mjankovec/MiSKo3/README.md

# MiSKo3
Student microcontroller development board based on STM32G474QET
