mjankovec/MiSKo3/Hardware/Panel production/Bill of Materials-MISKO3.xlsx

Line # | Designator | Code | Value | Description | Name | Quantity | Layer | Assembly | Provider | Manufacturer 1 | Manufacturer Part Number 1 | Supplier 1 | Supplier Part Number 1 | Supplier Unit Price 1
10 | A1 | Q-PBUTTON | Reset | Tactile switch SMD | Button_6x6 | 1 |  | Manual | FE | Wurth Electronics | 430182043816 | Würth elektronik | 430182043816 | 0.071
11 | BTN_DOWN1, BTN_ESC1, BTN_LEFT1, BTN_OK1, BTN_RIGHT1, BTN_UP1 | Q-PBUTTON | UI | Tactile switch SMD | Button_6x6 | 6 |  | Manual | FE | Wurth Electronics | 430182043816 | Würth elektronik | 430182043816 | 0.071
12 | C1, C2, C4, C5, C6, C7, C29, C30, C36 | NB7-4U7-25V | 4u7 | Capacitor |  | 9 |  | P&P | iSYSTEM
13 | C3 | NH4-1N2KV | 1n/2kV | Capacitor |  | 1 |  | P&P | iSYSTEM
14 | C8, C11, C17, C18, C19, C20, C21, C23, C27, C28, C35, C38, C39, C40, C42, C46, C50, C51, C52, C53, C54, C55, C56, C57, C58, C59, C60 | NB6-100N | 100n | Capacitor |  | 27 |  | P&P | iSYSTEM
15 | C9, C10, C14, C15, C16 | NB7-1U-25V | 1u | Capacitor |  | 5 |  | P&P | iSYSTEM
16 | C12, C13, C22, C24, C25 | NB2-10P | 10p | Capacitor |  | 5 |  | P&P | iSYSTEM
18 | C31, C32, C33, C34, C41, C43, C44, C45, C47, C48, C49 | NB2-10P, NB6-100N | NP | Capacitor |  | 11 |  | None
17 | C37 | NB4-1N | 1n | Capacitor |  | 1 |  | P&P | iSYSTEM
19 | D1 | KDSP3051 |  | TVS DIODE 6V 17V SOT23-6 | SP3051-04HTG | 1 |  | P&P | iSYSTEM
20 | D2, D3, D4, D5 | KDBAT54H |  | Schottky Barrier Diode, 2-Pin SOD-323, Pb-Free, Tape and Reel | BAT54HT1G | 4 |  | P&P | iSYSTEM
21 | D6 | KD-PESD1LIN |  | LIN-bus ESD protection diode | PESD1LIN | 1 |  | P&P | iSYSTEM
 | D7 | KD-NUP2125 |  | SOT23127P600-8N Dual Line Automotive Bus protection Datasheet: https://www.onsemi.com/pdf/datasheet/nup2125-d.pdf | NUP2125 | 1 |  | P&P | iSYSTEM
22 | D8, D9, D10, D11, D12, D13, D14, D15, D16, D17 | KD-ESD7371X |  | TVS Diode (Uni-directional) | ESD7371XV2T1G | 10 |  | P&P | iSYSTEM
23 | FB1, FB2 | LZ-FB0805 |  | Chip Ferrite Bead, 0805, 200Ω @ 100MHz, 0.26Ω, 25%, 500mA | BLM21BB201SN1D | 2 |  | P&P | iSYSTEM
24 | FID1, FID2, FID3 |  |  | according to IPC-7351 - is a 1mm diameter round dot with 2mm solder mask opening | Fiducial | 3 |  | Fiducial
25 | IC1 |  |  | FLASH - NOR Memory IC 128Mb (16M x 8) SPI - Quad I/O, QPI, DTR 133MHz 8-SOIC | W25Q128JVSIM | 1 |  | Optional | FE
26 | J1 | QBUSB-TYPEC-TM |  | USB 3.1 Type C Receptacle WR-COM, Horizontal, SMT / THT | 632723300011 | 1 |  | P&P | FE | Wurth Electronics | 632723300011 | Würth elektronik | 632723300011 | 1.49
27 | J2, J3 |  |  | Header 1x6 (male) | Header 1x6 (male) | 2 |  | None
28 | J4, J6, J8, J9, J10 |  |  | PINHD-1X8 | 8x1F-H8.5 | 5 |  | Manual | FE | Wurth Electronics | 61300811821 | Würth elektronik | 61300811821 | 0.01
29 | J5 |  |  | PINHD-2X18 | 18x2F-H8.5 | 1 |  | Manual | FE | Wurth Electronics | 61303621821 | Würth elektronik | 61303621821 | 0.01
30 | J7 |  |  | PINHD-1X10 | 10x1F-H8.5 | 1 |  | Manual | FE | Wurth Electronics | 61301011821 | Würth elektronik | 61301011821 | 0.01
31 | J11 |  |  | TE connectivity FPC 5 pin 0.5 mm ZIF top contact female connector 1734839-5 | FPC 5 pin | 1 |  | P&P | FE | TE Connectivity | 1734839-5 | Farnell | 3398656 | 0.268
32 | J12 | QYS50-20-M-SMD-LC |  | Trace/JTAG/SW connector | ESHF-110-01-L-D-SM-LC | 1 |  | Optional | iSYSTEM
33 | LED1, LED3, LED4 | KLC-G |  | Green light-emitting diode | GREEN | 3 |  | P&P | iSYSTEM
34 | LED2, LED5 | KLC-R |  | Red light-emitting diode | RED | 2 |  | P&P | iSYSTEM
35 | LED6, LED7, LED8, LED9, LED10, LED11, LED12, LED13 | KLB-B |  | LED | BLUE | 8 |  | Manual | iSYSTEM
36 | M1, M2 | BSH103-T/R |  | BSH103-T/R (NMOS) | BSS138 | 2 |  | P&P | iSYSTEM
37 | Q1 | KT-NPN-S |  | Bipolar (BJT) Transistor NPN 45V 100mA 100MHz 250mW Surface Mount TO-236AB | BC847C | 1 |  | P&P | iSYSTEM
38 | R1, R2, R3, R4, R14, R15, R16, R18, R21, R26, R27, R29, R32, R41, R43, R44, R52, R57, R58, R59, R62, R63, R94, R95 | LC5-10K | 10k | R |  | 24 |  | P&P | iSYSTEM
39 | R5 | LC7-1M | 1M | R |  | 1 |  | P&P | iSYSTEM
40 | R6, R7, R8, R9, R10, R11, R20, R22, R23, R24, R36, R37, R38, R47, R49, R50, R51, R60, R67, R68, R69, R70, R71, R72, R73, R74, R75, R76, R77, R78, R79, R80, R81, R82, R83, R84, R85, R86, R87, R88, R90, R91, R92, R93 | LC4-1K | 1k | R |  | 44 |  | P&P | iSYSTEM
41 | R12, R13, R25, R28, R30, R31, R33, R34, R39, R40, R42, R53, R54, R55, R56, R64, R65, R89 | LC2-56E | 56 | R |  | 18 |  | P&P | iSYSTEM
42 | R17, R19, R35, R45, R46, R48 | LC6-100K | 100k | R |  | 6 |  | P&P | iSYSTEM
43 | R61, R66 |  | NP | R |  | 2 |  | None
44 | SB1, SB2, SB3, SB4, SB5, SB6, SB7 |  |  |  | SD_JUMP | 7 |  | None
45 | T1, T2, T3, T4, T5, T6, T7, T8, T9, T10, T11, T12, T13 |  |  |  |  | 13 |  | None
 | U1 | FRL-33-LM1117 |  | 800mA Low-Dropout Linear Regulator, 4-pin SOT-223, Pb-Free DataSheet: https://www.ti.com/lit/ds/symlink/lm1117.pdf?ts=1629838143263 | LM1117MPX-3.3 | 1 |  | P&P | iSYSTEM | Texas Instruments | TEXASINSTRUMENTS
 | U2 | FS-MIC2544 |  | IC PWR SWITCH N-CHAN 1:1 8MSOP DataSheet: https://ww1.microchip.com/downloads/en/DeviceDoc/20005725B.pdf | MIC2548-1YM | 1 |  | P&P | iSYSTEM
 | U3 | FC-USB2422MJ |  | IC HUB CTLR USB 2.0 24QFN DataSheet: http://ww1.microchip.com/downloads/en/devicedoc/00001726b.pdf | USB2422/MJ | 1 |  | P&P | iSYSTEM
 | U4 | BSTM32F103CBT6 |  | ARM Cortex-M3 32-bit MCU, 128 KB Flash, 20 KB Internal RAM, 37 I/Os, 48-pin LQFP, -40 to 85 degC, Tray DataSheet: https://www.st.com/resource/en/datasheet/stm32f103c8.pdf About STLINK: https://www.st.com/resource/en/user_manual/dm00231744-stm32-nucleo-32-boards-mb1180-stmicroelectronics.pdf | STM32F103CBT6 | 1 |  | P&P | FE
6 | U5 | KLCD-XPT2046 |  | LCD touch controller | XPT2046 | 1 |  | P&P | FE | Shenzhen XPTEK Tech | XPT2046 | LCSC | C19076 | 0.303
47 | U6 |  |  |  | LCD_TFT_2.8inch | 1 |  | Manual | FE | WS Winstar | WF28ETLAJDNT0 | IC elektronika | WF28ETLAJDNT0 | 17.06
 | U7 | FC-TJA1027 |  | Integrated Circuit, LIN Transciever DataSheet: https://www.nxp.com/docs/en/data-sheet/TJA1027.pdf | MCP2004 | 1 |  | P&P | iSYSTEM
48 | U8 | FC-MCP2562FD |  | IC TRANSCEIVER 1/1 8SOIC | MCP2562FDT-E/SN | 1 |  | P&P | iSYSTEM
 | U9 | BSTM32G474QET6 |  | Mainstream Arm Cortex - M3 MCU 170Mhz with 512 Kbytes of Flash memory, Math Accelerator, HR timer, High Analog level integration DataSheet: https://www.st.com/en/microcontrollers-microprocessors/stm32g474qe.html | STM32G474QET6 | 1 |  | P&P | iSYSTEM
 | Y1 |  |  |  | CFPX-104 24MHz | 1 |  | P&P | FE |  |  | Würth elektronik | 830032817
 | Y2 |  |  |  | CFPX-104 8MHZ | 1 |  | P&P | FE |  |  | Würth elektronik | 830055901
