mjankovec/MiSKo3/Hardware/Documentation/Misko3 pin mapping.xlsx

Sheet: MCU pinout
Position | Name | Type | Signal | Label | AF0 | AF1 | AF2 | AF3 | AF4 | AF5 | AF6 | AF7 | AF8 | AF9 | AF10 | AF11 | AF12 | AF13 | AF14 | AF15
1 | PE2 | I/O | SYS_TRACECLK |  | SYS_TRACECLK |  | TIM3_CH1 | SAI1_CK1 |  | SPI4_SCK | TIM20_CH1 |  |  |  |  |  | FMC_A23 | SAI1_MCLK_A |  | EVENTOUT
2 | PE3 | I/O | SYS_TRACED0 |  | SYS_TRACED0 |  | TIM3_CH2 |  |  | SPI4_NSS | TIM20_CH2 |  |  |  |  |  | FMC_A19 | SAI1_SD_B |  | EVENTOUT
3 | PE4 | I/O | SYS_TRACED1 |  | SYS_TRACED1 |  | TIM3_CH3 | SAI1_D2 |  | SPI4_NSS | TIM20_CH1N |  |  |  |  |  | FMC_A20 | SAI1_FS_A |  | EVENTOUT
4 | PE5 | I/O | SYS_TRACED2 |  | SYS_TRACED2 |  | TIM3_CH4 | SAI1_CK2 |  | SPI4_MISO | TIM20_CH2N |  |  |  |  |  | FMC_A21 | SAI1_SCK_A |  | EVENTOUT
5 | PE6 | I/O | SYS_TRACED3 |  | SYS_TRACED3 |  |  | SAI1_D1 |  | SPI4_MOSI | TIM20_CH3N |  |  |  |  |  | FMC_A22 | SAI1_SD_A |  | EVENTOUT
6 | VBAT | Power
7 | PC13 | Input | GPIO_Input | JOY_BTN |  |  | TIM1_BKIN |  | TIM1_CH1N |  | TIM8_CH4N |  |  |  |  |  |  |  |  | EVENTOUT
8 | PC14-OSC32_IN | I/O | GPIO_EXTI14 | BTN_ESC |  |  |  |  |  |  |  |  |  |  |  |  |  |  |  | EVENTOUT
9 | PC15-OSC32_OUT | Input | GPIO_Input | BTN_OK |  |  |  |  |  |  |  |  |  |  |  |  |  |  |  | EVENTOUT
10 | PF3 | Output | GPIO_Output | LED1 |  |  | TIM20_CH4 |  | I2C3_SCL |  |  |  |  |  |  |  | FMC_A3 |  |  | EVENTOUT
11 | PF4 | Output | GPIO_Output | LED2 |  |  | COMP1_OUT | TIM20_CH1N | I2C3_SDA |  |  |  |  |  |  |  | FMC_A4 |  |  | EVENTOUT
12 | VSS | Power
13 | VDD | Power
14 | PF5 | Output | GPIO_Output | LED3 |  |  | TIM20_CH2N |  |  |  |  |  |  |  |  |  | FMC_A5 |  |  | EVENTOUT
15 | PF7 | I/O | TIM5_CH2 | PWM2 |  |  | TIM20_BKIN |  |  |  | TIM5_CH2 |  |  |  | QUADSPI1_BK1_IO2 |  | FMC_A1 | SAI1_MCLK_B |  | EVENTOUT
16 | PF8 | I/O | TIM5_CH3 | PWM3 |  |  | TIM20_BKIN2 |  |  |  | TIM5_CH3 |  |  |  | QUADSPI1_BK1_IO0 |  | FMC_A24 | SAI1_SCK_B |  | EVENTOUT
17 | PF9 | I/O | TIM5_CH4 | PWM4 |  |  | TIM20_BKIN | TIM15_CH1 |  | SPI2_SCK | TIM5_CH4 |  |  |  | QUADSPI1_BK1_IO1 |  | FMC_A25 | SAI1_FS_B |  | EVENTOUT
18 | PF10 | I/O | TIM15_CH2 | PWM5 |  |  | TIM20_BKIN2 | TIM15_CH2 |  | SPI2_SCK |  |  |  |  | QUADSPI1_CLK |  | FMC_A0 | SAI1_D3 |  | EVENTOUT
19 | PF0-OSC_IN | I/O | RCC_OSC_IN | MCI |  |  |  |  | I2C2_SDA | I2S2_WS/SPI2_NSS | TIM1_CH3N |  |  |  |  |  |  |  |  | EVENTOUT
20 | PF1-OSC_OUT | I/O | ADC2_IN10 | AD5 |  |  |  |  |  | I2S2_CK/SPI2_SCK |  |  |  |  |  |  |  |  |  | EVENTOUT
21 | PG10-NRST | I/O |  |  | RCC_MCO |  |  |  |  |  |  |  |  |  |  |  |  |  |  | EVENTOUT
22 | PC0 | Output | GPIO_Output | LED4 |  | LPTIM1_IN1 | TIM1_CH1 |  |  |  |  |  | LPUART1_RX |  |  |  |  |  |  | EVENTOUT
23 | PC1 | Output | GPIO_Output | LED5 |  | LPTIM1_OUT | TIM1_CH2 |  |  |  |  |  | LPUART1_TX |  | QUADSPI1_BK2_IO0 |  |  | SAI1_SD_A |  | EVENTOUT
24 | PC2 | Output | GPIO_Output | LED6 |  | LPTIM1_IN2 | TIM1_CH3 | COMP3_OUT |  |  | TIM20_CH2 |  |  |  | QUADSPI1_BK2_IO1 |  |  |  |  | EVENTOUT
25 | PC3 | Output | GPIO_Output | LED7 |  | LPTIM1_ETR | TIM1_CH4 | SAI1_D1 |  |  | TIM1_BKIN2 |  |  |  | QUADSPI1_BK2_IO2 |  |  | SAI1_SD_A |  | EVENTOUT
26 | PF2 | Output | GPIO_Output | LED0 |  |  | TIM20_CH3 |  | I2C2_SMBA |  |  |  |  |  |  |  | FMC_A2 |  |  | EVENTOUT
27 | PA0 | I/O | ADC1_IN1 | AD0 |  | TIM2_CH1 | TIM5_CH1 |  |  |  |  | USART2_CTS/USART2_NSS | COMP1_OUT | TIM8_BKIN | TIM8_ETR |  |  |  | TIM2_ETR | EVENTOUT
28 | PA1 | I/O | ADC1_IN2 | AD1 | RTC_REFIN | TIM2_CH2 | TIM5_CH2 |  |  |  |  | USART2_DE/USART2_RTS |  | TIM15_CH1N |  |  |  |  |  | EVENTOUT
29 | PA2 | I/O | ADC1_IN3 | AD2 |  | TIM2_CH3 | TIM5_CH3 |  |  |  |  | USART2_TX | COMP2_OUT | TIM15_CH1 | QUADSPI1_BK1_NCS |  | LPUART1_TX |  | UCPD1_FRSTX1/UCPD1_FRSTX2 | EVENTOUT
30 | VSS | Power
31 | VDD | Power
32 | PA3 | I/O | ADC1_IN4 | AD3 |  | TIM2_CH4 | TIM5_CH4 | SAI1_CK1 |  |  |  | USART2_RX |  | TIM15_CH2 | QUADSPI1_CLK |  | LPUART1_RX | SAI1_MCLK_A |  | EVENTOUT
33 | PA4 | I/O | DAC1_OUT1 | DAC0 |  |  | TIM3_CH2 |  |  | SPI1_NSS | I2S3_WS/SPI3_NSS | USART2_CK |  |  |  |  |  | SAI1_FS_B |  | EVENTOUT
34 | PA5 | I/O | ADC2_IN13 | AD8 |  | TIM2_CH1 | TIM2_ETR |  |  | SPI1_SCK |  |  |  |  |  |  |  |  | UCPD1_FRSTX1/UCPD1_FRSTX2 | EVENTOUT
35 | PA6 | I/O | DAC2_OUT1 | DAC0 |  | TIM16_CH1 | TIM3_CH1 |  | TIM8_BKIN | SPI1_MISO | TIM1_BKIN |  | COMP1_OUT |  | QUADSPI1_BK1_IO3 |  | LPUART1_CTS |  |  | EVENTOUT
36 | PA7 | I/O | QUADSPI1_BK1_IO2 | QSPI_IO2 |  | TIM17_CH1 | TIM3_CH2 |  | TIM8_CH1N | SPI1_MOSI | TIM1_CH1N |  | COMP2_OUT |  | QUADSPI1_BK1_IO2 |  |  |  | UCPD1_FRSTX1/UCPD1_FRSTX2 | EVENTOUT
37 | PC4 | I/O | ADC2_IN5 | AD4 |  |  | TIM1_ETR |  | I2C2_SCL |  |  | USART1_TX |  |  | QUADSPI1_BK2_IO3 |  |  |  |  | EVENTOUT
38 | PC5 | I/O | ADC2_IN11 | AD6 |  |  | TIM15_BKIN | SAI1_D3 |  |  | TIM1_CH4N | USART1_RX |  |  |  |  |  | HRTIM1_EEV10 |  | EVENTOUT
39 | PB0 | I/O | QUADSPI1_BK1_IO1 | QSPI_IO1 |  |  | TIM3_CH3 |  | TIM8_CH2N |  | TIM1_CH2N |  |  |  | QUADSPI1_BK1_IO1 |  |  | HRTIM1_FLT5 | UCPD1_FRSTX1/UCPD1_FRSTX2 | EVENTOUT
40 | PB1 | I/O | QUADSPI1_BK1_IO0 | QSPI_IO0 |  |  | TIM3_CH4 |  | TIM8_CH3N |  | TIM1_CH3N |  | COMP4_OUT |  | QUADSPI1_BK1_IO0 |  | LPUART1_DE/LPUART1_RTS | HRTIM1_SCOUT |  | EVENTOUT
41 | PB2 | I/O | ADC2_IN12 | AD7 | RTC_OUT2 | LPTIM1_OUT | TIM5_CH1 | TIM20_CH1 | I2C3_SMBA |  |  |  |  |  | QUADSPI1_BK2_IO1 |  |  | HRTIM1_SCIN |  | EVENTOUT
42 | VSSA | Power
43 | VREF+ | MonoIO
44 | VREF_+ | MonoIO
45 | VDDA | Power
46 | VSS | Power
47 | VDD | Power
48 | PF11 | I/O | FMC_NE4 | LCD1_CS |  |  | TIM20_ETR |  |  |  |  |  |  |  |  |  | FMC_NE4 |  |  | EVENTOUT
49 | PF12 | I/O | TIM20_CH1 | PWM6 |  |  | TIM20_CH1 |  |  |  |  |  |  |  |  |  | FMC_A6 |  |  | EVENTOUT
50 | PF13 | I/O | TIM20_CH2 | PWM7 |  |  | TIM20_CH2 |  | I2C4_SMBA |  |  |  |  |  |  |  | FMC_A7 |  |  | EVENTOUT
51 | PF14 | I/O | TIM20_CH3 | PWM8 |  |  | TIM20_CH3 |  | I2C4_SCL |  |  |  |  |  |  |  | FMC_A8 |  |  | EVENTOUT
52 | PF15 | I/O | TIM20_CH4 | PWM9 |  |  | TIM20_CH4 |  | I2C4_SDA |  |  |  |  |  |  |  | FMC_A9 |  |  | EVENTOUT
53 | PE7 | I/O | FMC_D4 |  |  |  | TIM1_ETR |  |  |  |  |  |  |  |  |  | FMC_D4/FMC_DA4 | SAI1_SD_B |  | EVENTOUT
54 | PE8 | I/O | FMC_D5 |  |  | TIM5_CH3 | TIM1_CH1N |  |  |  |  |  |  |  |  |  | FMC_D5/FMC_DA5 | SAI1_SCK_B |  | EVENTOUT
55 | PE9 | I/O | FMC_D6 |  |  | TIM5_CH4 | TIM1_CH1 |  |  |  |  |  |  |  |  |  | FMC_D6/FMC_DA6 | SAI1_FS_B |  | EVENTOUT
56 | PE10 | I/O | FMC_D7 |  |  |  | TIM1_CH2N |  |  |  |  |  |  |  | QUADSPI1_CLK |  | FMC_D7/FMC_DA7 | SAI1_MCLK_B |  | EVENTOUT
57 | PE11 | I/O | FMC_D8 |  |  |  | TIM1_CH2 |  |  | SPI4_NSS |  |  |  |  | QUADSPI1_BK1_NCS |  | FMC_D8/FMC_DA8 |  |  | EVENTOUT
58 | PE12 | I/O | FMC_D9 |  |  |  | TIM1_CH3N |  |  | SPI4_SCK |  |  |  |  | QUADSPI1_BK1_IO0 |  | FMC_D9/FMC_DA9 |  |  | EVENTOUT
59 | PE13 | I/O | FMC_D10 |  |  |  | TIM1_CH3 |  |  | SPI4_MISO |  |  |  |  | QUADSPI1_BK1_IO1 |  | FMC_D10/FMC_DA10 |  |  | EVENTOUT
60 | PE14 | I/O | FMC_D11 |  |  |  | TIM1_CH4 |  |  | SPI4_MOSI | TIM1_BKIN2 |  |  |  | QUADSPI1_BK1_IO2 |  | FMC_D11/FMC_DA11 |  |  | EVENTOUT
61 | PE15 | I/O | FMC_D12 |  |  |  | TIM1_BKIN |  |  |  | TIM1_CH4N | USART3_RX |  |  | QUADSPI1_BK1_IO3 |  | FMC_D12/FMC_DA12 |  |  | EVENTOUT
62 | PB10 | I/O | QUADSPI1_CLK | QSPI_CLK |  | TIM2_CH3 |  |  |  |  |  | USART3_TX | LPUART1_RX |  | QUADSPI1_CLK |  | TIM1_BKIN | HRTIM1_FLT3 | SAI1_SCK_A | EVENTOUT
63 | VSS | Power
64 | VDD | Power
65 | PB11 | I/O | QUADSPI1_BK1_NCS | QSPI_NCS |  | TIM2_CH4 |  |  |  |  |  | USART3_RX | LPUART1_TX |  | QUADSPI1_BK1_NCS |  |  | HRTIM1_FLT4 |  | EVENTOUT
66 | PB12 | I/O | FDCAN2_RX | CAN2_RX |  |  | TIM5_ETR |  | I2C2_SMBA | I2S2_WS/SPI2_NSS | TIM1_BKIN | USART3_CK | LPUART1_DE/LPUART1_RTS | FDCAN2_RX |  |  |  | HRTIM1_CHC1 |  | EVENTOUT
67 | PB13 | I/O | FDCAN2_TX | CAN2_TX |  |  |  |  |  | I2S2_CK/SPI2_SCK | TIM1_CH1N | USART3_CTS/USART3_NSS | LPUART1_CTS | FDCAN2_TX |  |  |  | HRTIM1_CHC2 |  | EVENTOUT
68 | PB14 | I/O | ADC4_IN4 | JOY_X |  | TIM15_CH1 |  |  |  | SPI2_MISO | TIM1_CH2N | USART3_DE/USART3_RTS | COMP4_OUT |  |  |  |  | HRTIM1_CHD1 |  | EVENTOUT
69 | PB15 | I/O | ADC4_IN5 | JOY_Y | RTC_REFIN | TIM15_CH2 | TIM15_CH1N | COMP3_OUT | TIM1_CH3N | I2S2_SD/SPI2_MOSI |  |  |  |  |  |  |  | HRTIM1_CHD2 |  | EVENTOUT
70 | PD8 | I/O | FMC_D13 |  |  |  |  |  |  |  |  | USART3_TX |  |  |  |  | FMC_D13/FMC_DA13 |  |  | EVENTOUT
71 | PD9 | I/O | FMC_D14 |  |  |  |  |  |  |  |  | USART3_RX |  |  |  |  | FMC_D14/FMC_DA14 |  |  | EVENTOUT
72 | PD10 | I/O | FMC_D15 |  |  |  |  |  |  |  |  | USART3_CK |  |  |  |  | FMC_D15/FMC_DA15 |  |  | EVENTOUT
73 | PD11 | I/O | ADC3_IN8 | AD9 |  | TIM5_ETR |  |  | I2C4_SMBA |  |  | USART3_CTS/USART3_NSS |  |  |  |  | FMC_A16 |  |  | EVENTOUT
74 | PD12 | I/O | ADC3_IN9 | AD10 |  |  | TIM4_CH1 |  |  |  |  | USART3_DE/USART3_RTS |  |  |  |  | FMC_A17 |  |  | EVENTOUT
75 | PD13 | I/O | ADC3_IN10 | AD11 |  |  | TIM4_CH2 |  |  |  |  |  |  |  |  |  | FMC_A18 |  |  | EVENTOUT
76 | PD14 | I/O | FMC_D0 |  |  |  | TIM4_CH3 |  |  |  |  |  |  |  |  |  | FMC_D0/FMC_DA0 |  |  | EVENTOUT
77 | PD15 | I/O | FMC_D1 |  |  |  | TIM4_CH4 |  |  |  | SPI2_NSS |  |  |  |  |  | FMC_D1/FMC_DA1 |  |  | EVENTOUT
78 | VSS | Power
79 | VDD | Power
80 | PC6 | I/O | TIM8_CH1 | PWM10 |  |  | TIM3_CH1 | HRTIM1_EEV10 | TIM8_CH1 |  | I2S2_MCK | COMP6_OUT | I2C4_SCL |  |  |  |  | HRTIM1_CHF1 |  | EVENTOUT
81 | PC7 | I/O | TIM8_CH2 | PWM11 |  |  | TIM3_CH2 | HRTIM1_FLT5 | TIM8_CH2 |  | I2S3_MCK | COMP5_OUT | I2C4_SDA |  |  |  |  | HRTIM1_CHF2 |  | EVENTOUT
82 | PG0 | Input | GPIO_Input | BTN_UP |  |  | TIM20_CH1N |  |  |  |  |  |  |  |  |  | FMC_A10 |  |  | EVENTOUT
83 | PG1 | Input | GPIO_Input | BTN_DOWN |  |  | TIM20_CH2N |  |  |  |  |  |  |  |  |  | FMC_A11 |  |  | EVENTOUT
84 | PG2 | I/O | SPI1_SCK |  |  |  | TIM20_CH3N |  |  | SPI1_SCK |  |  |  |  |  |  | FMC_A12 |  |  | EVENTOUT
85 | PG3 | I/O | SPI1_MISO |  |  |  | TIM20_BKIN |  | I2C4_SCL | SPI1_MISO | TIM20_CH4N |  |  |  |  |  | FMC_A13 |  |  | EVENTOUT
86 | PG4 | I/O | SPI1_MOSI |  |  |  | TIM20_BKIN2 |  | I2C4_SDA | SPI1_MOSI |  |  |  |  |  |  | FMC_A14 |  |  | EVENTOUT
87 | PC8 | I/O | TIM8_CH3 | PWM12 |  |  | TIM3_CH3 | HRTIM1_CHE1 | TIM8_CH3 |  | TIM20_CH3 | COMP7_OUT | I2C3_SCL |  |  |  |  |  |  | EVENTOUT
88 | PC9 | I/O | TIM8_CH4 | PWM13 |  |  | TIM3_CH4 | HRTIM1_CHE2 | TIM8_CH4 | I2S_CKIN | TIM8_BKIN2 |  | I2C3_SDA |  |  |  |  |  |  | EVENTOUT
89 | PA8 | I/O | I2C2_SDA |  | RCC_MCO |  | I2C3_SCL |  | I2C2_SDA | I2S2_MCK | TIM1_CH1 | USART1_CK | COMP7_OUT |  | TIM4_ETR | FDCAN3_RX | SAI1_CK2 | HRTIM1_CHA1 | SAI1_SCK_A | EVENTOUT
90 | PA9 | I/O | I2C2_SCL |  |  |  | I2C3_SMBA |  | I2C2_SCL | I2S3_MCK | TIM1_CH2 | USART1_TX | COMP5_OUT | TIM15_BKIN | TIM2_CH3 |  |  | HRTIM1_CHA2 | SAI1_FS_A | EVENTOUT
91 | PA10 | I/O | USART1_RX |  |  | TIM17_BKIN |  | CRS_SYNC | I2C2_SMBA | SPI2_MISO | TIM1_CH3 | USART1_RX | COMP6_OUT |  | TIM2_CH4 | TIM8_BKIN | SAI1_D1 | HRTIM1_CHB1 | SAI1_SD_A | EVENTOUT
92 | PA11 | I/O | USB_DM | USB_MCU_N |  |  |  |  |  | I2S2_SD/SPI2_MOSI | TIM1_CH1N | USART1_CTS/USART1_NSS | COMP1_OUT | FDCAN1_RX | TIM4_CH1 | TIM1_CH4 | TIM1_BKIN2 | HRTIM1_CHB2 |  | EVENTOUT
93 | PA12 | I/O | USB_DP | USB_MCU_P |  | TIM16_CH1 |  |  |  | I2S_CKIN | TIM1_CH2N | USART1_DE/USART1_RTS | COMP2_OUT | FDCAN1_TX | TIM4_CH2 | TIM1_ETR |  | HRTIM1_FLT1 |  | EVENTOUT
94 | VSS | Power
95 | VDD | Power
96 | PA13 | I/O | SYS_JTMS-SWDIO | SWDIO | SYS_JTMS-SWDIO | TIM16_CH1N |  | I2C4_SCL | I2C1_SCL | IR_OUT |  | USART3_CTS/USART3_NSS |  |  | TIM4_CH3 |  |  | SAI1_SD_B |  | EVENTOUT
97 | PF6 | I/O | QUADSPI1_BK1_IO3 | QSPI_IO3 |  | TIM5_ETR | TIM4_CH4 | SAI1_SD_B | I2C2_SCL |  | TIM5_CH1 | USART3_RTS |  |  | QUADSPI1_BK1_IO3 |  |  |  |  | EVENTOUT
98 | PA14 | I/O | SYS_JTCK-SWCLK | SWCLK | SYS_JTCK-SWCLK | LPTIM1_OUT |  | I2C4_SMBA | I2C1_SDA | TIM8_CH2 | TIM1_BKIN | USART2_TX |  |  |  |  |  | SAI1_FS_B |  | EVENTOUT
99 | PA15 | I/O | I2C1_SCL |  | SYS_JTDI | TIM2_CH1 | TIM8_CH1 |  | I2C1_SCL | SPI1_NSS | I2S3_WS/SPI3_NSS | USART2_RX | UART4_DE/UART4_RTS | TIM1_BKIN |  | FDCAN3_TX |  | HRTIM1_FLT2 | TIM2_ETR | EVENTOUT
100 | PC10 | I/O | UART4_TX |  |  |  |  |  | TIM8_CH1N | UART4_TX | I2S3_CK/SPI3_SCK | USART3_TX |  |  |  |  |  | HRTIM1_FLT6 |  | EVENTOUT
101 | PC11 | I/O | UART4_RX |  |  |  |  | HRTIM1_EEV2 | TIM8_CH2N | UART4_RX | SPI3_MISO | USART3_RX | I2C3_SDA |  |  |  |  |  |  | EVENTOUT
102 | PC12 | I/O | UART5_TX | LIN_TX |  | TIM5_CH2 |  | HRTIM1_EEV1 | TIM8_CH3N | UART5_TX | I2S3_SD/SPI3_MOSI | USART3_CK |  |  |  |  |  |  | UCPD1_FRSTX1/UCPD1_FRSTX2 | EVENTOUT
103 | PG5 | I/O | FMC_A15 | LCD_RS |  |  | TIM20_ETR |  |  | SPI1_NSS |  |  | LPUART1_CTS |  |  |  | FMC_A15 |  |  | EVENTOUT
104 | PG6 | Input | GPIO_Input | BTN_LEFT |  |  | TIM20_BKIN |  | I2C3_SMBA |  |  |  | LPUART1_DE/LPUART1_RTS |  |  |  | FMC_INT |  |  | EVENTOUT
105 | PG7 | Output | GPIO_Output | CAN_STBY |  |  |  | SAI1_CK1 | I2C3_SCL |  |  |  | LPUART1_TX |  |  |  | FMC_INT | SAI1_MCLK_A |  | EVENTOUT
106 | PG8 | Input | GPIO_Input | BTN_RIGHT |  |  |  |  | I2C3_SDA |  |  |  | LPUART1_RX |  |  |  | FMC_NE3 |  |  | EVENTOUT
107 | PG9 | I/O | USART1_TX |  |  |  |  |  |  |  | SPI3_SCK | USART1_TX |  |  |  |  | FMC_NCE/FMC_NE2 |  | TIM15_CH1N | EVENTOUT
108 | PD0 | I/O | FMC_D2 |  |  |  |  |  |  |  | TIM8_CH4N |  |  | FDCAN1_RX |  |  | FMC_D2/FMC_DA2 |  |  | EVENTOUT
109 | PD1 | I/O | FMC_D3 |  |  |  |  |  | TIM8_CH4 |  | TIM8_BKIN2 |  |  | FDCAN1_TX |  |  | FMC_D3/FMC_DA3 |  |  | EVENTOUT
110 | VSS | Power
111 | VDD | Power
112 | PD2 | I/O | UART5_RX | LIN_RX |  |  | TIM3_ETR |  | TIM8_BKIN | UART5_RX |  |  |  |  |  |  |  |  |  | EVENTOUT
113 | PD3 | Output | GPIO_Output | LIN_SLP |  |  | TIM2_CH1/TIM2_ETR |  |  |  |  | USART2_CTS/USART2_NSS |  |  | QUADSPI1_BK2_NCS |  | FMC_CLK |  |  | EVENTOUT
114 | PD4 | I/O | FMC_NOE | LCD_RD |  |  | TIM2_CH2 |  |  |  |  | USART2_DE/USART2_RTS |  |  | QUADSPI1_BK2_IO0 |  | FMC_NOE |  |  | EVENTOUT
115 | PD5 | I/O | FMC_NWE | LCD_WR |  |  |  |  |  |  |  | USART2_TX |  |  | QUADSPI1_BK2_IO1 |  | FMC_NWE |  |  | EVENTOUT
116 | PD6 | I/O | GPIO_EXTI6 | TOUCH_IRQ |  |  | TIM2_CH4 | SAI1_D1 |  |  |  | USART2_RX |  |  | QUADSPI1_BK2_IO2 |  | FMC_NWAIT | SAI1_SD_A |  | EVENTOUT
117 | PD7 | I/O | FMC_NE1 | LCD_CS |  |  | TIM2_CH3 |  |  |  |  | USART2_CK |  |  | QUADSPI1_BK2_IO3 |  | FMC_NCE/FMC_NE1 |  |  | EVENTOUT
118 | PB3 | I/O | USART2_TX |  | SYS_JTDO-SWO | TIM2_CH2 | TIM4_ETR | CRS_SYNC | TIM8_CH1N | SPI1_SCK | I2S3_CK/SPI3_SCK | USART2_TX |  |  | TIM3_ETR | FDCAN3_RX | HRTIM1_SCOUT | HRTIM1_EEV9 | SAI1_SCK_B | EVENTOUT
119 | PB4 | I/O | USART2_RX |  | SYS_JTRST | TIM16_CH1 | TIM3_CH1 |  | TIM8_CH2N | SPI1_MISO | SPI3_MISO | USART2_RX | UART5_DE/UART5_RTS |  | TIM17_BKIN | FDCAN3_TX |  | HRTIM1_EEV7 | SAI1_MCLK_B | EVENTOUT
120 | PB5 | Output | GPIO_Output | LCD_RST |  | TIM16_BKIN | TIM3_CH2 | TIM8_CH3N | I2C1_SMBA | SPI1_MOSI | I2S3_SD/SPI3_MOSI | USART2_CK | I2C3_SDA | FDCAN2_RX | TIM17_CH1 | LPTIM1_IN1 | SAI1_SD_B | HRTIM1_EEV6 | UART5_CTS | EVENTOUT
121 | PB6 | Output | GPIO_Output | LCD_BKLT |  | TIM16_CH1N | TIM4_CH1 |  |  | TIM8_CH1 | TIM8_ETR | USART1_TX | COMP4_OUT | FDCAN2_TX | TIM8_BKIN2 | LPTIM1_ETR | HRTIM1_SCIN | HRTIM1_EEV4 | SAI1_FS_B | EVENTOUT
122 | PB7 | I/O | I2C1_SDA |  |  | TIM17_CH1N | TIM4_CH2 | I2C4_SDA | I2C1_SDA | TIM8_BKIN |  | USART1_RX | COMP3_OUT |  | TIM3_CH4 | LPTIM1_IN2 | FMC_NL | HRTIM1_EEV3 | UART4_CTS | EVENTOUT
123 | PB8-BOOT0 | I/O | USART3_RX |  |  | TIM16_CH1 | TIM4_CH3 | SAI1_CK1 | I2C1_SCL |  |  | USART3_RX | COMP1_OUT | FDCAN1_RX | TIM8_CH2 |  | TIM1_BKIN | HRTIM1_EEV8 | SAI1_MCLK_A | EVENTOUT
124 | PB9 | I/O | USART3_TX |  |  | TIM17_CH1 | TIM4_CH4 | SAI1_D2 | I2C1_SDA |  | IR_OUT | USART3_TX | COMP2_OUT | FDCAN1_TX | TIM8_CH3 |  | TIM1_CH3N | HRTIM1_EEV5 | SAI1_FS_A | EVENTOUT
125 | PE0 | Output | GPIO_Output | FLASH_CS |  |  | TIM4_ETR | TIM20_CH4N | TIM16_CH1 |  | TIM20_ETR | USART1_TX |  |  |  |  | FMC_NBL0 |  |  | EVENTOUT
126 | PE1 | Output | GPIO_Output | TOUCH_CS |  |  |  |  | TIM17_CH1 |  | TIM20_CH4 | USART1_RX |  |  |  |  | FMC_NBL1 |  |  | EVENTOUT
127 | VSS | Power
128 | VDD | Power

Sheet: Misko3 pinout
MCU |  |  |  |  | Connector |  |  | Arduino |  | TIMERS |  |  |  |  |  | COMP | COMMUNICATION INTERFACES |  |  |  |  |  |  | OTHER PERIPHERAL UNITS
MCU pin | MCU port/pin | MCU pin type | MCU default function | Peripherals | Label Connector | RefDes connector | Pin connector | Pin arduino | Name arduino | Advanced | Advanced/General | General 1 | General 2 | LPTIM1 | HRTIM1 | COMPx | SPI | I2C | I2S | SAI1 | USART | QSPI/FDCAN | FMC | CRS | USB-C PD
27 | PA0 | I/O | ADC1_IN1 |  | AD0 | J8 | 1 |  | A0 | TIM8_BKIN/ETR | TIM2_CH1/ETR | TIM5_CH1 |  |  |  | COMP1_OUT |  |  |  |  | USART2_CTS/NSS
28 | PA1 | I/O | ADC1_IN2 |  | AD1 | J8 | 2 |  | A1 |  | TIM2_CH2 | TIM5_CH2 | TIM15_CH1N |  |  |  |  |  |  |  | USART2_DE/RTS
34 | PA5 | I/O | ADC2_IN13 |  | AD8 | J10 | 1 |  | A8 |  | TIM2_CH1/ETR |  |  |  |  |  | SPI1_SCK |  |  |  |  |  |  |  | UCPD1_FRSTX1/UCPD1_FRSTX2
73 | PD11 | I/O | ADC3_IN8 |  | AD9 | J10 | 2 |  | A9 |  |  | TIM5_ETR |  |  |  |  |  | I2C4_SMBA |  |  | USART3_CTS/NSS |  | FMC_A16
29 | PA2 | I/O | ADC1_IN3 |  | AD2 | J8 | 3 |  | A2 |  | TIM2_CH3 | TIM5_CH3 | TIM15_CH1 |  |  | COMP2_OUT |  |  |  |  | USART2_TX/LPUART1_TX | QSPI1_BK1_NCS |  |  | UCPD1_FRSTX1/UCPD1_FRSTX2
32 | PA3 | I/O | ADC1_IN4 |  | AD3 | J8 | 4 |  | A3 |  | TIM2_CH4 | TIM5_CH4 | TIM15_CH2 |  |  |  |  |  |  | CK1/MCLK_A | USART2_RX/LPUART1_RX | QSPI1_CLK
37 | PC4 | I/O | ADC2_IN5 |  | AD4 | J8 | 5 |  | A4 | TIM1_ETR |  |  |  |  |  |  |  | I2C2_SCL |  |  | USART1_TX | QSPI1_BK2_IO3
20 | PF1-OSC_OUT | I/O | ADC2_IN10 |  | AD5 | J8 | 6 |  | A5 |  |  |  |  |  |  |  | SPI2_SCK |  | I2S2_CK
38 | PC5 | I/O | ADC2_IN11 |  | AD6 | J8 | 7 |  | A6 | TIM1_CH4N |  |  | TIM15_BKIN |  | EEV10 |  |  |  |  | D3 | USART1_RX
41 | PB2 | I/O | ADC2_IN12 |  | AD7 | J8 | 8 |  | A7 | TIM20_CH1 |  | TIM5_CH1 |  | OUT | SCIN |  |  | I2C3_SMBA |  |  |  | QSPI1_BK2_IO1
74 | PD12 | I/O | ADC3_IN9 |  | AD10 | J10 | 3 |  | A10 |  |  | TIM4_CH1 |  |  |  |  |  |  |  |  | USART3_DE/RTS |  | FMC_A17
75 | PD13 | I/O | ADC3_IN10 |  | AD11 | J10 | 4 |  | A11 |  |  | TIM4_CH2 |  |  |  |  |  |  |  |  |  |  | FMC_A18
 |  |  |  |  |  | J5 | 1 |  | 5V
83 | PG1 | Input | GPIO_Input |  | BTN_DOWN
8 | PC14-OSC32_IN | I/O | GPIO_EXTI14 | Buttons | BTN_ESC
104 | PG6 | Input | GPIO_Input | Buttons | BTN_LEFT
9 | PC15-OSC32_OUT | Input | GPIO_Input | Buttons | BTN_OK
106 | PG8 | Input | GPIO_Input | Buttons | BTN_RIGHT
82 | PG0 | Input | GPIO_Input | Buttons | BTN_UP
105 | PG7 | Output | GPIO_Output | CAN interface | CAN_STBY
66 | PB12 | I/O | FDCAN2_RX | CAN interface | CAN2_RX
67 | PB13 | I/O | FDCAN2_TX | CAN interface | CAN2_TX
33 | PA4 | I/O | DAC1_OUT1 |  | DAC1 | J10 | 5 |  | DA0 |  |  | TIM3_CH2 |  |  |  |  | SPI1_NSS/SPI3_NSS |  | I2S3_WS | FS_B | USART2_CK
35 | PA6 | I/O | DAC2_OUT1 |  | DAC2 | J10 | 6 |  | DA1 | TIM1_BKIN | TIM8_BKIN | TIM3_CH1 | TIM16_CH1 |  |  | COMP1_OUT | SPI1_MISO |  |  |  | LPUART1_CTS | QSPI1_BK1_IO3
 |  |  |  |  |  | J5 | 2 |  | 5V
57 | PE11 | I/O | FMC_D8 | LCD display | FMC_D8 | J5 | 3 | 22 |  | TIM1_CH2 |  |  |  |  |  |  | SPI4_NSS |  |  |  |  | QSPI1_BK1_NCS
58 | PE12 | I/O | FMC_D9 | LCD display | FMC_D9 | J5 | 4 | 23 |  | TIM1_CH3N |  |  |  |  |  |  | SPI4_SCK |  |  |  |  | QSPI1_BK1_IO0
59 | PE13 | I/O | FMC_D10 | LCD display | FMC_D10 | J5 | 5 | 24 |  | TIM1_CH3 |  |  |  |  |  |  | SPI4_MISO |  |  |  |  | QSPI1_BK1_IO1
60 | PE14 | I/O | FMC_D11 | LCD display | FMC_D11 | J5 | 6 | 25 |  | TIM1_CH4/BKIN2 |  |  |  |  |  |  | SPI4_MOSI |  |  |  |  | QSPI1_BK1_IO2
61 | PE15 | I/O | FMC_D12 | LCD display | FMC_D12 | J5 | 7 | 26 |  | TIM1_CH4N/BKIN |  |  |  |  |  |  |  |  |  |  | USART3_RX | QSPI1_BK1_IO3
70 | PD8 | I/O | FMC_D13 | LCD display | FMC_D13 | J5 | 8 | 27 |  |  |  |  |  |  |  |  |  |  |  |  | USART3_TX
71 | PD9 | I/O | FMC_D14 | LCD display | FMC_D14 | J5 | 9 | 28 |  |  |  |  |  |  |  |  |  |  |  |  | USART3_RX
72 | PD10 | I/O | FMC_D15 | LCD display | FMC_D15 | J5 | 10 | 29 |  |  |  |  |  |  |  |  |  |  |  |  | USART3_CK
56 | PE10 | I/O | FMC_D7 | LCD display | FMC_D7 | J5 | 11 | 30 |  | TIM1_CH2N |  |  |  |  |  |  |  |  |  | MCLK_B |  | QSPI1_CLK
55 | PE9 | I/O | FMC_D6 | LCD display | FMC_D6 | J5 | 12 | 31 |  | TIM1_CH1 |  | TIM5_CH4 |  |  |  |  |  |  |  | FS_B
54 | PE8 | I/O | FMC_D5 | LCD display | FMC_D5 | J5 | 13 | 32 |  | TIM1_CH1N |  | TIM5_CH3 |  |  |  |  |  |  |  | SCK_B
53 | PE7 | I/O | FMC_D4 | LCD display | FMC_D4 | J5 | 14 | 33 |  | TIM1_ETR |  |  |  |  |  |  |  |  |  | SD_B
109 | PD1 | I/O | FMC_D3 | LCD display | FMC_D3 | J5 | 15 | 34 |  | TIM8_CH4/BKIN2 |  |  |  |  |  |  |  |  |  |  |  | FDCAN1_TX
108 | PD0 | I/O | FMC_D2 | LCD display | FMC_D2 | J5 | 16 | 35 |  | TIM8_CH4N |  |  |  |  |  |  |  |  |  |  |  | FDCAN1_RX
77 | PD15 | I/O | FMC_D1 | LCD display | FMC_D1 | J5 | 17 | 36 |  |  |  | TIM4_CH4 |  |  |  |  | SPI2_NSS
76 | PD14 | I/O | FMC_D0 | LCD display | FMC_D0 | J5 | 18 | 37 |  |  |  | TIM4_CH3
51 | PF14 | I/O | TIM20_CH3 |  | PWM8 | J7 | 1 | 8 | PWM8 |  |  |  |  |  |  |  |  | I2C4_SCL |  |  |  |  | FMC_A8
52 | PF15 | I/O | TIM20_CH4 |  | PWM9 | J7 | 2 | 9 | PWM9 |  |  |  |  |  |  |  |  | I2C4_SDA |  |  |  |  | FMC_A9
90 | PA9 | I/O | I2C2_SCL |  | I2C2_SCL | J4 | 1 | 21 | SCL | TIM1_CH2 |  | TIM2_CH3 | TIM15_BKIN |  | CHA2 | COMP5_OUT |  | I2C3_SMBA | I2S3_MCK | FS_A | USART1_TX
89 | PA8 | I/O | I2C2_SDA |  | I2C2_SDA | J4 | 2 | 20 | SDA | TIM1_CH1 |  | TIM4_ETR |  |  | CHA1 | COMP7_OUT |  | I2C3_SCL | I2S2_MCK | CK2/SCK_A | USART1_CK | FDCAN3_RX
7 | PC13 | Input | GPIO_Input | Joystick | JOY_BTN | J11 | 3 |  |  | TIM1_CH1N/BKIN | TIM8_CH4N
68 | PB14 | I/O | ADC4_IN4 | Joystick | JOY_X | J11 | 4 |  |  | TIM1_CH2N |  |  | TIM15_CH1 |  | CHD1 | COMP4_OUT | SPI2_MISO |  |  |  | USART3_DE/RTS
69 | PB15 | I/O | ADC4_IN5 | Joystick | JOY_Y | J11 | 1 |  |  | TIM1_CH3N |  |  | TIM15_CH2/CH1N |  | CHD2 | COMP3_OUT | SPI2_MOSI |  | I2S2_SD
103 | PG5 | I/O | FMC_A15 | LCD display | LCD_RS | J5 | 19 | 38 |  | TIM20_ETR |  |  |  |  |  |  | SPI1_NSS |  |  |  | LPUART1_CTS
117 | PD7 | I/O | FMC_NE1 | LCD display | LCD_CS
115 | PD5 | I/O | FMC_NWE | LCD display | LCD_WR | J5 | 20 | 39 |  |  |  |  |  |  |  |  |  |  |  |  | USART2_TX | QSPI1_BK2_IO1
48 | PF11 | Output | FMC_NE4 | FMC on J5 chip select | ARDUINO_CS | J5 | 21 | 40 |  | TIM20_ETR
113 | PD3 | Output | GPIO_Output | LCD display | LCD_RESET | J5 | 22 | 41 |  |  |  | TIM2_CH1/ETR |  |  |  |  |  |  |  |  | USART2_CTS/NSS | QSPI1_BK2_NCS | FMC_CLK
 |  |  |  | LIN interface |  | J5 | 23 |  | LIN
26 | PF2 | Output | GPIO_Output | LED array | LED0 |  |  |  |  | TIM20_CH3
10 | PF3 | Output | GPIO_Output | LED array | LED1 |  |  |  |  | TIM20_CH4
11 | PF4 | Output | GPIO_Output | LED array | LED2 |  |  |  |  | TIM20_CH1N |  |  |  |  |  | COMP1_OUT
14 | PF5 | Output | GPIO_Output | LED array | LED3 |  |  |  |  | TIM20_CH2N
22 | PC0 | Output | GPIO_Output | LED array | LED4 |  |  |  |  | TIM1_CH1
23 | PC1 | Output | GPIO_Output | LED array | LED5 |  |  |  |  | TIM1_CH2 |  |  |  | OUT
24 | PC2 | Output | GPIO_Output | LED array | LED6 |  |  |  |  | TIM1_CH3 | TIM20_CH2 |  |  |  |  | COMP3_OUT
25 | PC3 | Output | GPIO_Output | LED array | LED7 |  |  |  |  | TIM1_CH4
119 | PB4 | I/O | USART2_RX |  | USART2_RX | J4 | 3 | 19 | RX1 | TIM8_CH2N | TIM3_CH1 | TIM16_CH1 | TIM17_BKIN |  | EEV7 | TIM16_CH1 | SPI1_MISO/SPI3_MISO |  |  | MCLK_B | UART5_DE/RTS | FDCAN3_TX
125 | PE0 | Output | GPIO_Output | LIN interface | LIN_SLEEP |  |  |  |  |  |  |  |  |  |  |  |  |  |  |  | USART1_TX |  | FMC_NBL0
118 | PB3 | I/O | USART2_TX |  | USART2_TX | J4 | 4 | 18 | TX1 | TIM8_CH1N | TIM2_CH2 | TIM3_ETR | TIM4_ETR |  | EEV9/SCOUT |  | SPI1_SCK/SPI3_SCK |  | I2S3_CK | SCK_B |  | FDCAN3_RX |  | CRS_SYNC
19 | PF0-OSC_IN | I/O | RCC_OSC_IN | Clock input from ST-Link | MCI
80 | PC6 | I/O | TIM8_CH1 |  | PWM10 | J7 | 3 | 10 | PWM10 |  |  | TIM3_CH1 |  |  | CHF1/EEV10 | COMP6_OUT |  | I2C4_SCL | I2S2_MCK
81 | PC7 | I/O | TIM8_CH2 |  | PWM11 | J7 | 4 | 11 | PWM11 |  |  | TIM3_CH2 |  |  | CHF2/FLT5 | COMP5_OUT |  | I2C4_SDA | I2S3_MCK
87 | PC8 | I/O | TIM8_CH3 |  | PWM12 | J7 | 5 | 12 | PWM12 | TIM20_CH3 |  | TIM3_CH3 |  |  | CHE1 | COMP7_OUT |  | I2C3_SCL
88 | PC9 | I/O | TIM8_CH4 |  | PWM13 | J7 | 6 | 13 | PWM13 |  | TIM8_BKIN2 | TIM3_CH4 |  |  | CHE2 |  |  | I2C3_SDA | I2S_CKIN
91 | PA10 | I/O | USART1_RX |  | USART1_RX | J6 | 1 | 0 | RX0 | TIM1_CH3 | TIM8_BKIN | TIM2_CH4 | TIM17_BKIN |  | CHB1 | COMP6_OUT | SPI2_MISO | I2C2_SMBA |  | D1/SD_A |  |  |  | CRS_SYNC
107 | PG9 | I/O | USART1_TX |  | USART1_TX | J6 | 2 | 1 | TX0 |  |  |  | TIM15_CH1N |  |  |  | SPI3_SCK |  |  |  |  |  | FMC_NCE/NE2
15 | PF7 | I/O | TIM5_CH2 |  | PWM2 | J6 | 3 | 2 | PWM2 | TIM20_BKIN |  |  |  |  |  |  |  |  |  | MCLK_B |  | QSPI1_BK1_IO2 | FMC_A1
16 | PF8 | I/O | TIM5_CH3 |  | PWM3 | J6 | 4 | 3 | PWM3 | TIM20_BKIN2 |  |  |  |  |  |  |  |  |  | SCK_B |  | QSPI1_BK1_IO0 | FMC_A24
17 | PF9 | I/O | TIM5_CH4 |  | PWM4 | J6 | 5 | 4 | PWM4 | TIM20_BKIN |  |  | TIM15_CH1 |  |  |  | SPI2_SCK |  |  | FS_B |  | QSPI1_BK1_IO1 | FMC_A25
18 | PF10 | I/O | TIM15_CH2 |  | PWM5 | J6 | 6 | 5 | PWM5 | TIM20_BKIN2 |  |  |  |  |  |  | SPI2_SCK |  |  | D3 |  | QSPI1_CLK | FMC_A0
12 | VSS | Power |  |  |  | J7 | 7 |  | GND
43 | VREF+ | MonoIO |  | Analog reference I/O |  | J7 | 8 |  | AREF
62 | PB10 | I/O | QSPI1_CLK | Optional QSPI memory | QSPI_CLK
114 | PD4 | I/O | FMC_NOE | LCD display | LCD_RD | J5 | 24 | 43 |  |  |  | TIM2_CH2 |  |  |  |  |  |  |  |  | USART2_DE/RTS | QSPI1_BK2_IO0
116 | PD6 | I/O | GPIO_EXTI6 | Touch interface | TOUCH_IRQ | J5 | 25 | 44 |  |  |  | TIM2_CH4 |  |  |  |  |  |  |  | D1/SD_A | USART2_RX | QSPI1_BK2_IO2 | FMC_NWAIT
120 | PB5 | Output | GPIO_Output |  | FLASH_CS | J5 | 26 | 45 |  | TIM16_BKIN | TIM3_CH2 | TIM8_CH3N | TIM17_CH1 | LPTIM1_IN1 |  |  | SPI1_MOSI/SPI3_MOSI | I2C1_SMBA/I2C3_SDA | I2S3_SD | SAI1_SD_B | USART2_CK/UART5_CTS | FDCAN2_RX
97 | PF6 | I/O | QSPI1_BK1_IO3 | Optional QSPI memory | QSPI_IO3
65 | PB11 | I/O | QSPI1_BK1_NCS | Optional QSPI memory | QSPI_NCS
40 | PB1 | I/O | QSPI1_BK1_IO0 | Optional QSPI memory | QSPI_IO0 | J5 | 27 | 46 |  | TIM1_CH3N | TIM8_CH3N | TIM3_CH4 |  |  | SCOUT | COMP4_OUT |  |  |  |  | LPUART1_DE/RTS
39 | PB0 | I/O | QSPI1_BK1_IO1 | Optional QSPI memory | QSPI_IO1 | J5 | 28 | 47 |  | TIM1_CH2N | TIM8_CH2N | TIM3_CH3 |  |  | FLT5 |  |  |  |  |  |  |  |  |  | UCPD1_FRSTX1/UCPD1_FRSTX2
121 | PB6 | Output | GPIO_Output | LCD display | LCD_BKLT | J5 | 29 | 48 |  | TIM8_CH1/ETR/BKIN2 |  | TIM4_CH1 | TIM16_CH1N | ETR | EEV4/SCIN | COMP4_OUT |  |  |  | FS_B | USART1_TX | FDCAN2_TX
98 | PA14 | I/O | SYS_JTCK-SWCLK | Debug interface | SWCLK | J12 | 4 |  |  | TIM1_BKIN | TIM8_CH2 |  |  | OUT |  |  |  | I2C1_SDA/I2C4_SMBA |  | FS_B | USART2_TX
96 | PA13 | I/O | SYS_JTMS-SWDIO | Debug interface | SWDIO | J12 | 2 |  |  | IR_OUT |  | TIM4_CH3 | TIM16_CH1N |  |  |  |  | I2C1_SCL/I2C4_SCL |  | SD_B | USART3_CTS/NSS
1 | PE2 | I/O | SYS_TRACECLK | Debug interface | SYS_TRACECLK | J12 | 12 |  |  | TIM20_CH1 |  | TIM3_CH1 |  |  |  |  | SPI4_SCK |  |  | CK1/MCKL_A |  |  | FMC_A23
2 | PE3 | I/O | SYS_TRACED0 | Debug interface | SYS_TRACED0 | J12 | 14 |  |  | TIM20_CH2 |  | TIM3_CH2 |  |  |  |  | SPI4_NSS |  |  | SD_B |  |  | FMC_A19
3 | PE4 | I/O | SYS_TRACED1 | Debug interface | SYS_TRACED1 | J12 | 16 |  |  | TIM20_CH1N |  | TIM3_CH3 |  |  |  |  | SPI4_NSS |  |  | D2/FS_A |  |  | FMC_A20
4 | PE5 | I/O | SYS_TRACED2 | Debug interface | SYS_TRACED2 | J12 | 18 |  |  | TIM20_CH2N |  | TIM3_CH4 |  |  |  |  | SPI4_MISO |  |  | CK2/SCK_A |  |  | FMC_A21
5 | PE6 | I/O | SYS_TRACED3 | Debug interface | SYS_TRACED3 | J12 | 20 |  |  | TIM20_CH3N |  |  |  |  |  |  | SPI4_MOSI |  |  | D1/SD_A |  |  | FMC_A22
36 | PA7 | I/O | QSPI1_BK1_IO2 | Optional QSPI memory | QSPI_IO2 | J5 | 30 | 49 |  | TIM1_CH1N | TIM8_CH1N | TIM3_CH2 | TIM17_CH1 |  |  | COMP2_OUT | SPI1_MOSI |  |  |  |  |  |  |  | UCPD1_FRSTX1/UCPD1_FRSTX2
85 | PG3 | I/O | SPI1_MISO | Touch interface | SPI1_MISO | J5 | 31 | 50 |  | TIM20_CH4N/BKIN |  |  |  |  |  |  |  | I2C4_SCL |  |  |  |  | FMC_A13
101 | PC11 | I/O | UART4_RX |  | UART4_RX | J4 | 5 | 17 | RX2 | TIM8_CH2N |  |  |  |  | EEV2 |  | SPI3_MISO | I2C3_SDA |  |  | USART3_RX
100 | PC10 | I/O | UART4_TX |  | UART4_TX | J4 | 6 | 16 | TX2 | TIM8_CH1N |  |  |  |  | FLT6 |  | SPI3_SCK |  | I2S3_CK |  | USART3_TX
49 | PF12 | I/O | TIM20_CH1 |  | PWM6 | J6 | 7 | 6 | PWM6 |  |  |  |  |  |  |  |  |  |  |  |  |  | FMC_A6
50 | PF13 | I/O | TIM20_CH2 |  | PWM7 | J6 | 8 | 7 | PWM7 |  |  |  |  |  |  |  |  | I2C4_SMBA |  |  |  |  | FMC_A7
112 | PD2 | I/O | UART5_RX | LIN interface | LIN_RX | J4 | 7 | 15 | RX3 | TIM8_BKIN |  | TIM3_ETR
102 | PC12 | I/O | UART5_TX | LIN interface | LIN_TX | J4 | 8 | 14 | TX3 | TIM8_CH3N |  | TIM5_CH2 |  |  | EEV1 |  | SPI3_MOSI |  | I2S3_SD |  | USART3_CK |  |  |  | UCPD1_FRSTX1/UCPD1_FRSTX2
123 | PB8-BOOT0 | I/O | USART3_RX | VCP via ST-Link | USART3_RX
124 | PB9 | I/O | USART3_TX | VCP via ST-Link | USART3_TX
92 | PA11 | I/O | USB_DM | USB interace | USB_MCU_N
93 | PA12 | I/O | USB_DP | USB interace | USB_MCU_P
6 | VBAT | Power
122 | PB7 | I/O | I2C1_SDA |  | I2C1_SDA | J7 | 9 |  | SDA1 | TIM8_BKIN |  | TIM4_CH2/TIM3_CH4 | TIM17_CH1N | IN2 | EEV3 | COMP3_OUT |  | I2C4_SDA |  |  | USART1_RX/UART4_CTS |  | FMC_NL
13 | VDD | Power
111 | VDD | Power |  | 3V3 output |  | J9 | 2 |  | 3V3
86 | PG4 | I/O | SPI1_MOSI | Touch interface | SPI1_MOSI | J5 | 32 | 51 |  | TIM20_BKIN2 |  |  |  |  |  |  |  | I2C4_SDA |  |  |  |  | FMC_A14
31 | VDD | Power
42 | VSSA | Power
99 | PA15 | I/O | I2C1_SCL |  | I2C1_SCL | J7 | 10 |  | SCL1 | TIM1_BKIN | TIM8_CH1 | TIM2_CH1/ETR |  |  | FLT2 |  | SPI1_NSS/SPI3_NSS |  | I2S3_WS |  | USART2_RX/UART4_DE/RTS | FDCAN3_TX
44 | VREF_+ | MonoIO
45 | VDDA | Power
84 | PG2 | I/O | SPI1_SCK | Touch interface | SPI1_SCK | J5 | 33 | 52 |  | TIM20_CH3N |  |  |  |  |  |  |  |  |  |  |  |  | FMC_A12
47 | VDD | Power
21 | PG10-NRST | I/O |  | MCU reset input |  | J9 | 3 |  | RST
64 | VDD | Power
128 | VDD | Power |  | 3V3 output |  | J9 | 4 |  | 3V3
79 | VDD | Power
94 | VSS | Power
95 | VDD | Power
110 | VSS | Power
 |  |  |  | USB 5V output |  | J9 | 5 |  | 5V
127 | VSS | Power
78 | VSS | Power |  |  |  | J9 | 6 |  | GND
63 | VSS | Power |  |  |  | J9 | 7 |  | GND
126 | PE1 | Output | GPIO_Output | Touch interface | TOUCH_CS | J5 | 34 | 53 |  | TIM20_CH4 |  |  | TIM17_CH1 |  |  |  |  |  |  |  | USART1_RX |  | FMC_NBL1
30 | VSS | Power |  |  |  | J5 | 35 |  | GND
 |  |  |  | LIN 12V power input |  | J9 | 8 |  | 12V (LIN)
 |  |  |  |  |  | J10 | 7 |  | CANL
 |  |  |  |  |  | J10 | 8 |  | CANH
46 | VSS | Power |  |  |  | J5 | 36 |  | GND

Sheet: FMC muxed PSRAM
MCU port/pin | MUXED PSRAM | Arduino con | pin # | Miško3 signal | Column2 | Column3 | MUXED PSRAM with clock | Arduino con4 | pin #5 | Miško3 signal6
PD12 | FMC_A17 | J10 | 3 | 0 |  | PD11 | FMC_A16 | J10 | 2 | 0
PD13 | FMC_A18 | J10 | 4 | 0 |  | PD12 | FMC_A17 | J10 | 3 | 0
PD14 | FMC_D0;FMC_DA0 | J5 | 18 | LCD display |  | PD13 | FMC_A18 | J10 | 4 | 0
PD4 | FMC_NOE | J5 | 24 | LCD display |  | PD3 | FMC_CLK |  |  | LCD display
PD15 | FMC_D1;FMC_DA1 | J5 | 17 | LCD display |  | PD14 | FMC_D0;FMC_DA0 | J5 | 18 | LCD display
PE0 | FMC_NBL0 | J5 | 26 | LIN interface |  | PD15 | FMC_D1;FMC_DA1 | J5 | 17 | LCD display
PE14 | FMC_D11;FMC_DA11 | J5 | 6 | LCD display |  | PE13 | FMC_D10;FMC_DA10 | J5 | 5 | LCD display
PE15 | FMC_D12;FMC_DA12 | J5 | 7 | LCD display |  | PE14 | FMC_D11;FMC_DA11 | J5 | 6 | LCD display
PF11 | FMC_NE4 | J5 | 21 | FMC on J5 chip select |  | PE15 | FMC_D12;FMC_DA12 | J5 | 7 | LCD display
PD9 | FMC_D14;FMC_DA14 | J5 | 9 | LCD display |  | PD8 | FMC_D13;FMC_DA13 | J5 | 8 | LCD display
PD10 | FMC_D15;FMC_DA15 | J5 | 10 | LCD display |  | PD9 | FMC_D14;FMC_DA14 | J5 | 9 | LCD display
PD11 | FMC_A16 | J10 | 2 | 0 |  | PD10 | FMC_D15;FMC_DA15 | J5 | 10 | LCD display
PD0 | FMC_D2;FMC_DA2 | J5 | 16 | LCD display |  | PD0 | FMC_D2;FMC_DA2 | J5 | 16 | LCD display
PD1 | FMC_D3;FMC_DA3 | J5 | 15 | LCD display |  | PD1 | FMC_D3;FMC_DA3 | J5 | 15 | LCD display
PE8 | FMC_D5;FMC_DA5 | J5 | 13 | LCD display |  | PE7 | FMC_D4;FMC_DA4 | J5 | 14 | LCD display
PE9 | FMC_D6;FMC_DA6 | J5 | 12 | LCD display |  | PE8 | FMC_D5;FMC_DA5 | J5 | 13 | LCD display
PE10 | FMC_D7;FMC_DA7 | J5 | 11 | LCD display |  | PE9 | FMC_D6;FMC_DA6 | J5 | 12 | LCD display
PE11 | FMC_D8;FMC_DA8 | J5 | 3 | LCD display |  | PE10 | FMC_D7;FMC_DA7 | J5 | 11 | LCD display
PE12 | FMC_D9;FMC_DA9 | J5 | 4 | LCD display |  | PE11 | FMC_D8;FMC_DA8 | J5 | 3 | LCD display
PE13 | FMC_D10;FMC_DA10 | J5 | 5 | LCD display |  | PE12 | FMC_D9;FMC_DA9 | J5 | 4 | LCD display
PE1 | FMC_NBL1 | J5 | 34 | Touch interface |  | PE0 | FMC_NBL0 | J5 | 26 | LIN interface
PE7 | FMC_D4;FMC_DA4 | J5 | 14 | LCD display |  | PE1 | FMC_NBL1 | J5 | 34 | Touch interface
 |  |  |  |  |  | PF11 | FMC_NE4 | J5 | 21 | FMC on J5 chip select
PB7 | FMC_NL | J7 | 9 | 0 |  | PB7 | FMC_NL | J7 | 9 | 0
PD5 | FMC_NWE | J5 | 20 | LCD display |  | PD4 | FMC_NOE | J5 | 24 | LCD display
PD8 | FMC_D13;FMC_DA13 | J5 | 8 | LCD display |  | PD6 | FMC_NWAIT | J5 | 25 | Touch interface
PD6 | FMC_NWAIT | J5 | 25 | Touch interface |  | PD5 | FMC_NWE | J5 | 20 | LCD display
