mjankovec/MiSKo3/Hardware/3D models/Case/Gumb.stl

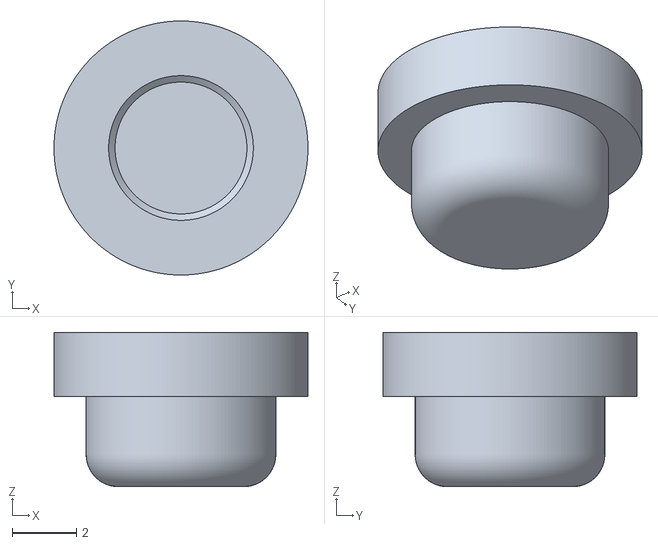
[picture p1: CAD file, 2023-03-21]
Hardware/3D models/Case/Gumb.stl
7.90 x 7.90 x 4.80
