mjankovec/MiSKo3/Hardware/3D models/Switch Joystick.STEP

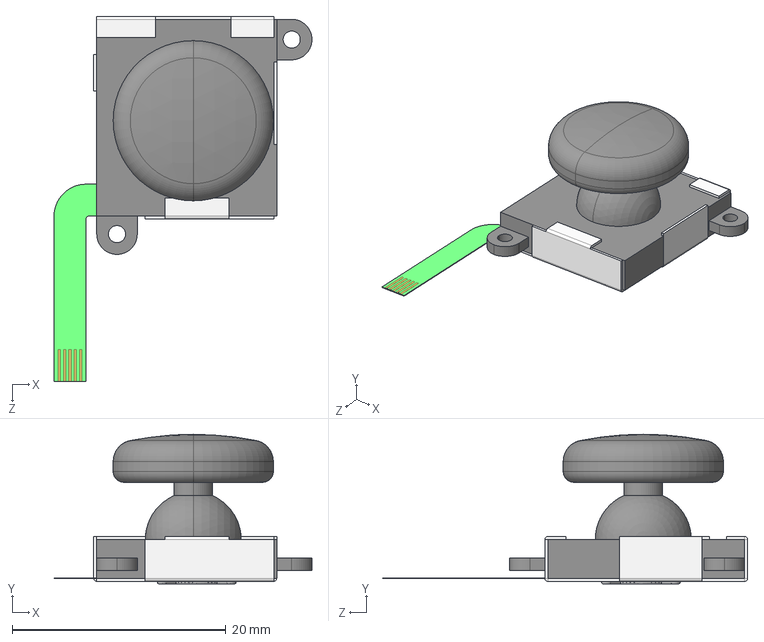
[picture p2: CAD file, 2022-12-28]
Hardware/3D models/Switch Joystick.STEP
24.2 x 14.0 x 34.2 mm
Sheet
Part3^Switch Joystick
