mjankovec/MiSKo3/Hardware/Panel production/Misko 3 pleksi holder.dxf

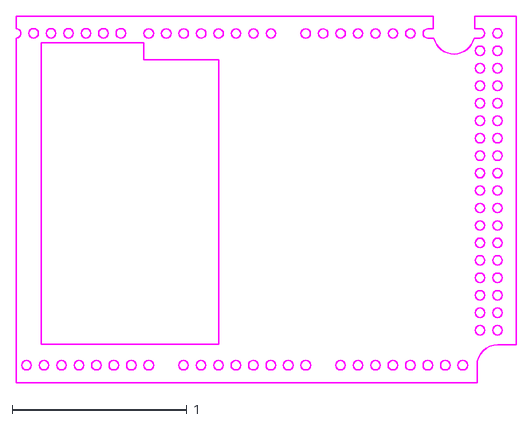
[picture p3: CAD file, 2022-12-28]
Hardware/Panel production/Misko 3 pleksi holder.dxf
2.86 x 2.10
