mjankovec/MiSKo3/Hardware/3D models/Case/Gumb_reset.stl

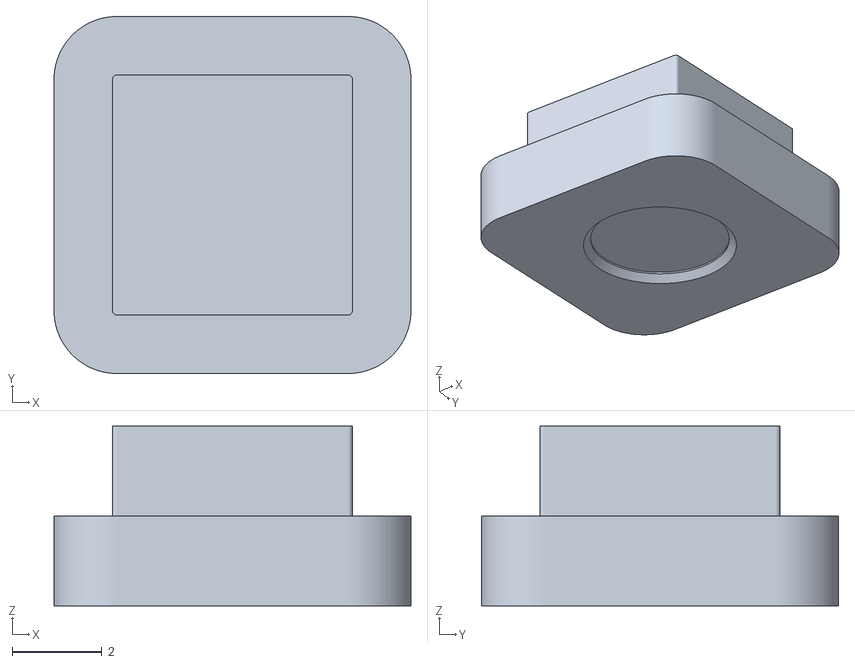
[picture p4: CAD file, 2023-03-21]
Hardware/3D models/Case/Gumb_reset.stl
7.94 x 7.94 x 4.00
