mjankovec/MiSKo3/Hardware/3D models/Case/Front.stl

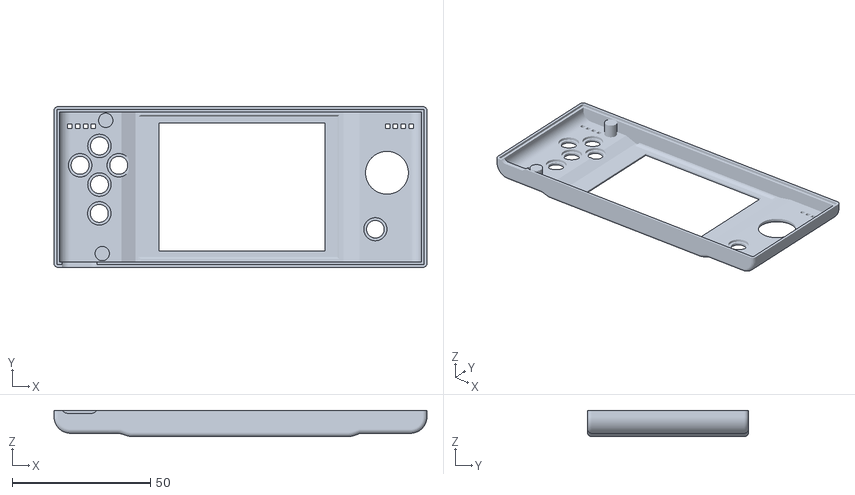
[picture p5: CAD file, 2023-03-21]
Hardware/3D models/Case/Front.stl
135.1 x 58.3 x 9.51
