mjankovec/MiSKo3/Hardware/3D models/Case/Back.stl

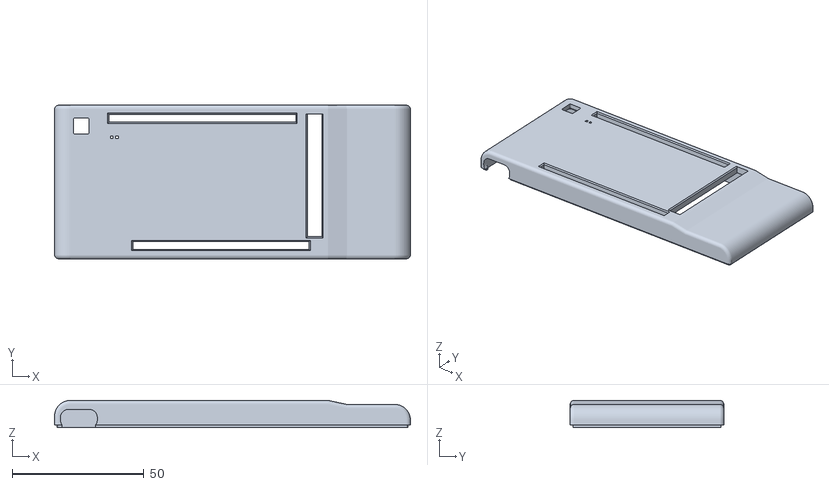
[picture p6: CAD file, 2023-03-21]
Hardware/3D models/Case/Back.stl
135.1 x 58.3 x 10.3
