mjankovec/MiSKo3/Hardware/Documentation/Changelog.docx

1. Swapped pins 120-PB5 and 125-PE0

V1.0

V1.1

2. Changed reset circuit, that resets the microcontroller in case of missing MCO clock:

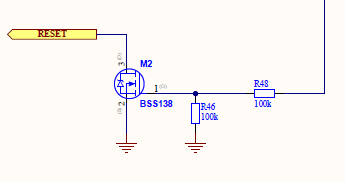
[picture p7: figure]

3. Changed reset pullup resistor R93 (10k -> 1k) and reset button series resistor (1k->56R):

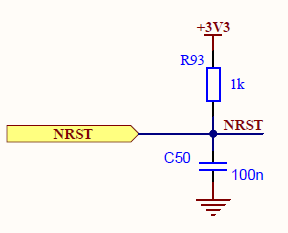
[picture p8: figure]
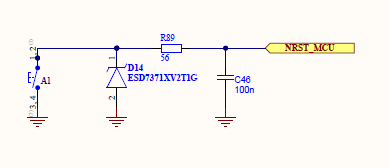
[picture p9: figure]
