mjankovec/MiSKo3/(list of files, drawings)

Other design files:
Hardware/Altium project/ARDUINO_GPIO.SchDoc
Hardware/Altium project/BUTTONS.SchDoc
Hardware/Altium project/CAN + LIN.SchDoc
Hardware/Altium project/HIREARCHY.SchDoc
Hardware/Altium project/JOYSTICK + LED.SchDoc
Hardware/Altium project/LCD + TOUCH .SchDoc
Hardware/Altium project/MCU.SchDoc
Hardware/Altium project/MISKO3.PrjPcb
Hardware/Altium project/Misko 3 panel.PcbDoc
Hardware/Altium project/POWER.SchDoc
Hardware/Altium project/QSPI.SchDoc
Hardware/Altium project/STLINK_2.1.SchDoc
Hardware/Altium project/Trace.SchDoc
Hardware/Altium project/USB_C.SchDoc
Hardware/Altium project/USB_HUB.SchDoc
Hardware/Shield Altium project/ARDUINO_GPIO.SchDoc
Hardware/Shield Altium project/MISKO3 shield.PrjPcb
Hardware/Shield Altium project/Misko 3 shield.PcbDoc
