mjankovec/MiSKo3/(commit log)

2022-12-29 Several bugs corrected in LCD driver including ILI9341_WaitTransfer _HW_FillFrame, LCD_FillRect, Low level FMC write function when optimization was ON LCD and UGUI connection moved to separate c file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
    [Test.ioc, joystick.c, main.c, main.h]
2023-02-20 Added soldering instructions
2023-02-22 Added soldering pptx with video links
2023-02-28 File names changed
    [Bill of Materials-MISKO3 v1.0.xlsx, MISKO3 1.0 shield.PrjPcb, MISKO3 v1.0.PrjPcb, Misko 3 1.0 panel.PcbDoc, Misko 3 1.0 pleksi holder.dxf, Misko 3 1.0 shield.PcbDoc, Misko 3 PCB_1.0 panel.PcbDoc, Misko3 v1.0 pin mapping.xlsx]
2023-02-28 updated Outjob file.
    [Bill of Materials-MISKO3.xlsx, MISKO3 shield.PrjPcb, MISKO3.PrjPcb, Misko 3 panel.PcbDoc, Misko 3 pleksi holder.dxf, Misko 3 shield.PcbDoc, Misko3 pin mapping.xlsx, Pick Place for Misko 3.csv]
2023-02-28 v1.1 HW and SW changes to v1.0 All changes are documented in Hardware\Documentation\Changelog.docx file.
    [ARDUINO_GPIO.SchDoc, BUTTONS.SchDoc, Bill of Materials-MISKO3.xlsx, CAN + LIN.SchDoc, HIREARCHY.SchDoc, JOYSTICK + LED.SchDoc, LCD + TOUCH .SchDoc, MCU.SchDoc]
2023-03-01 - Added connector naming in MiSKo3.PDF and Misko3.PCBDwf - change Arduino naming in MISKO3 pin mapping.xlsx
    [Misko3 pin mapping.xlsx]
2023-03-21 Added case files for misko
    [Back.stl, Front.stl, Gumb.stl, Gumb_reset.stl]
